ashlynblack/kbd-single/artifacts/front.png

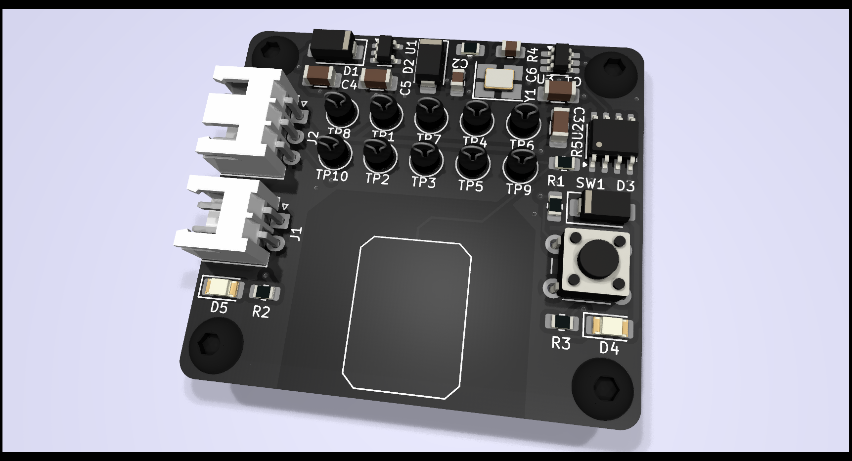
artifacts/front.png
