ashlynblack/kbd-single/artifacts/back.png

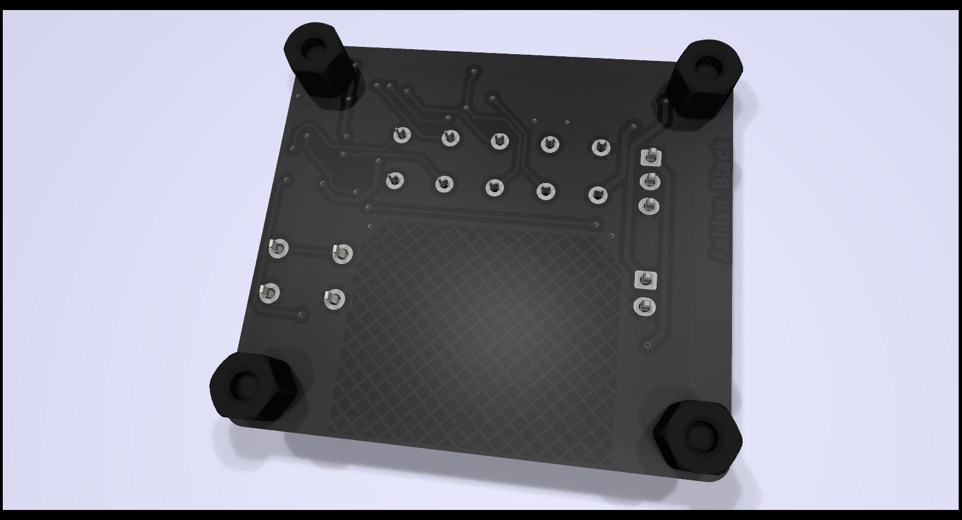
artifacts/back.png
