ashlynblack/kbd-single/artifacts/layout.pdf

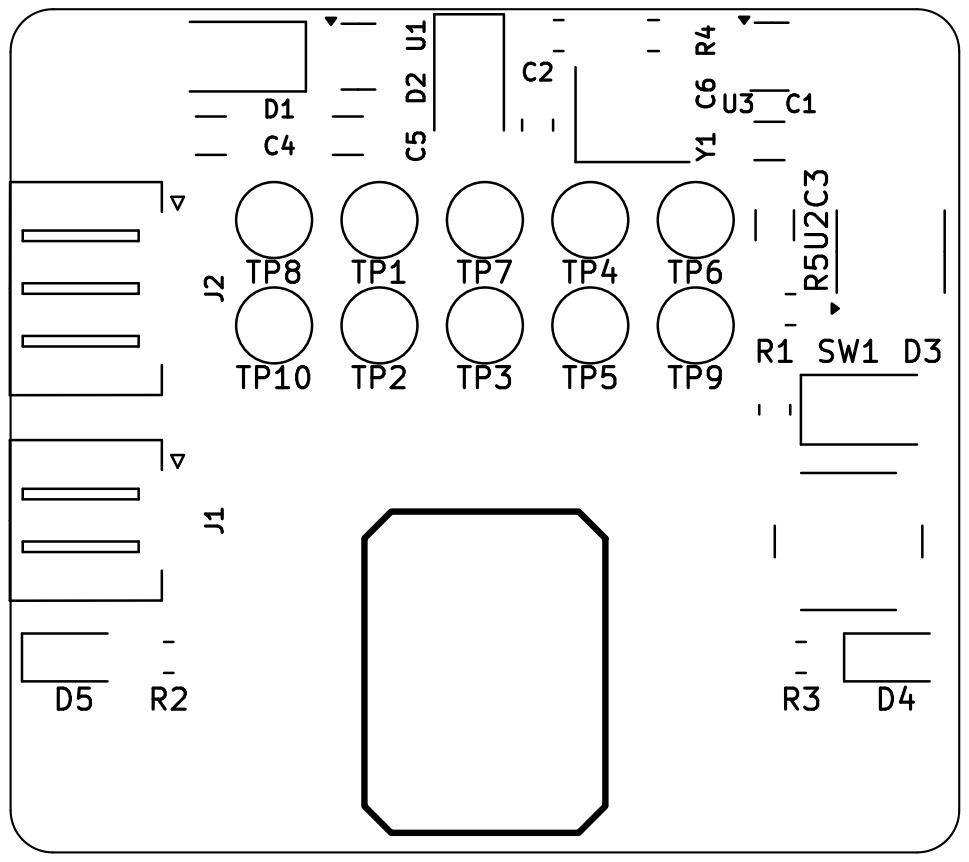
[picture p3: page 1]

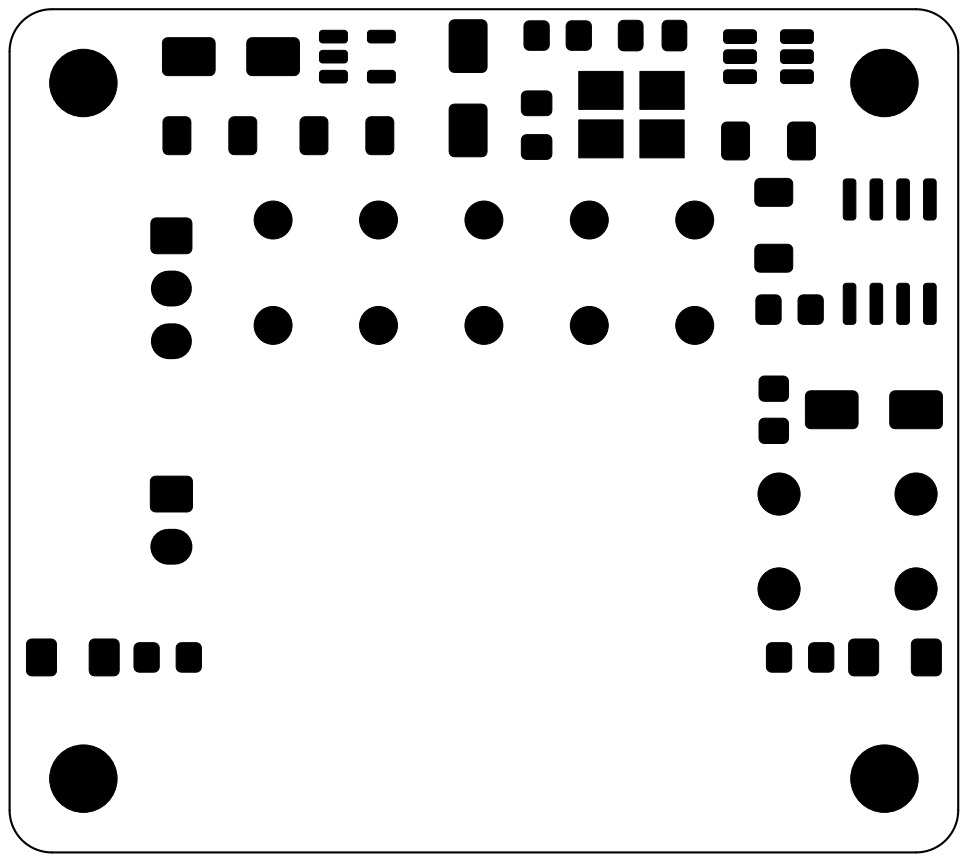
[picture p4: page 2]
D Date: 2024-07-27 KiCad; E.D.A. 8.0.4 Size: A4; Rev: 0; Id: 1/1 Title: Capacitive Touch Test File: single.kicad_pcb Sheet: Ashlyn; Black

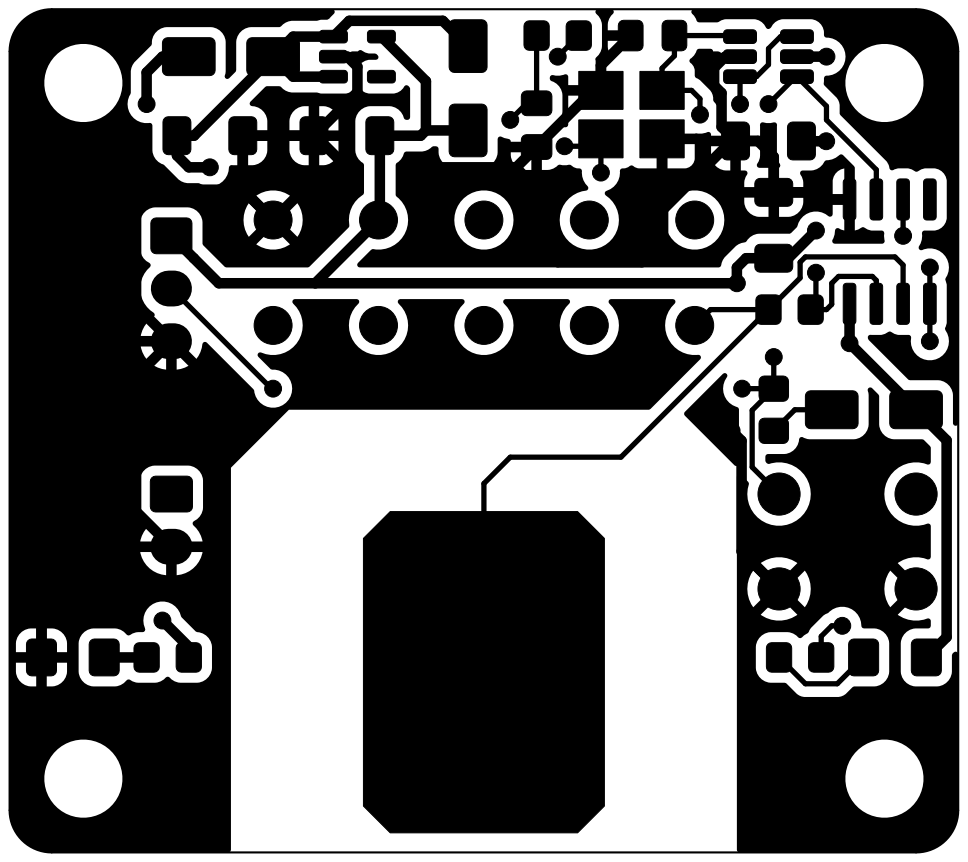
[picture p5: page 3]
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

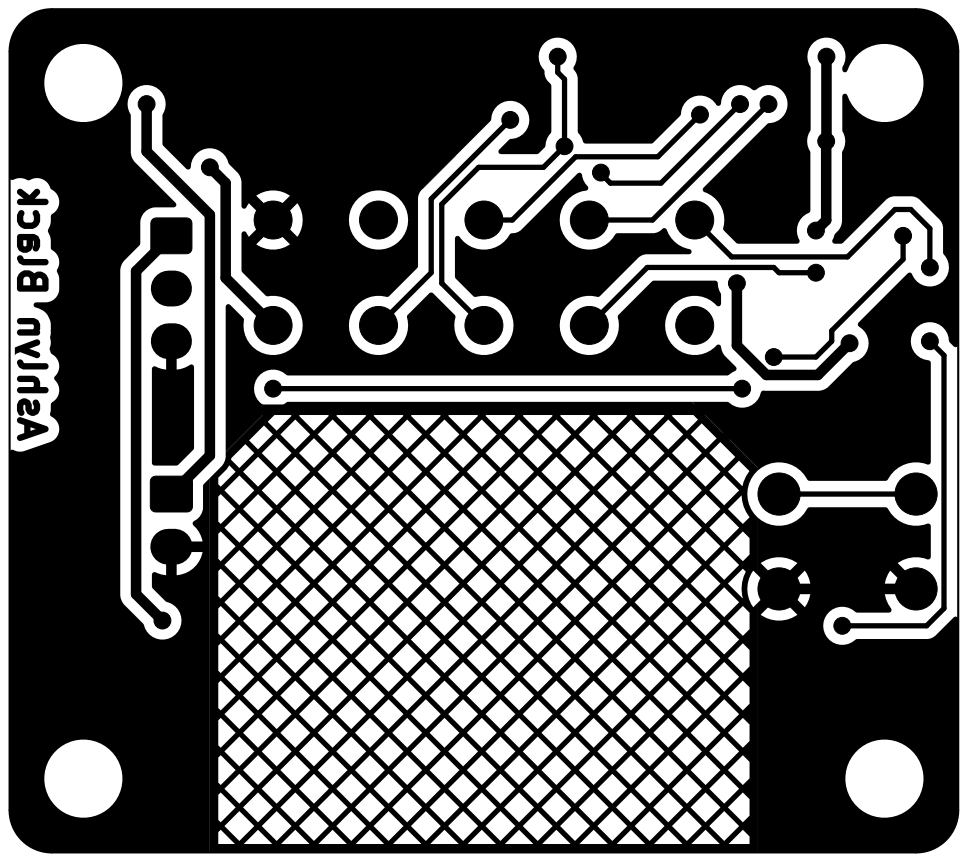
[picture p6: page 4]
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

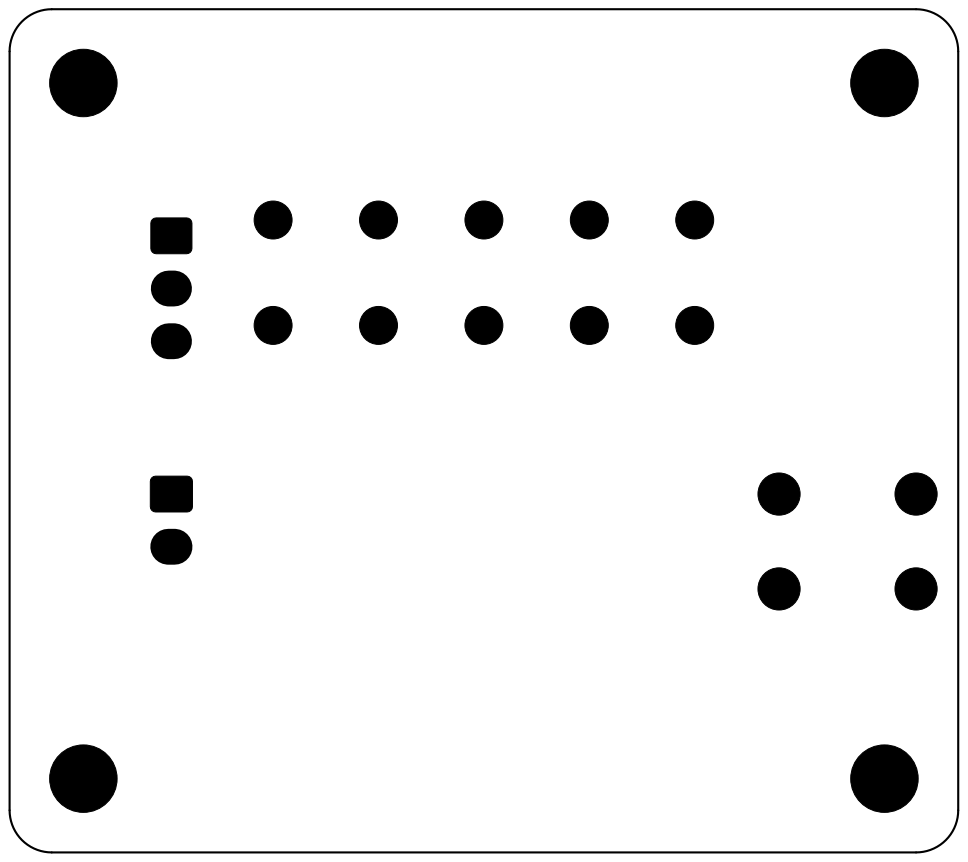
[picture p7: page 5]
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

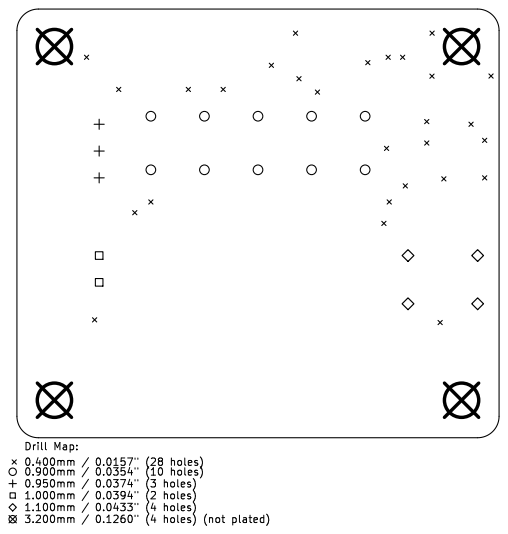
[picture p8: page 6]
Drill; Map:; holes); holes) (not; plated)
