ashlynblack/kbd-single/artifacts/schematic.pdf

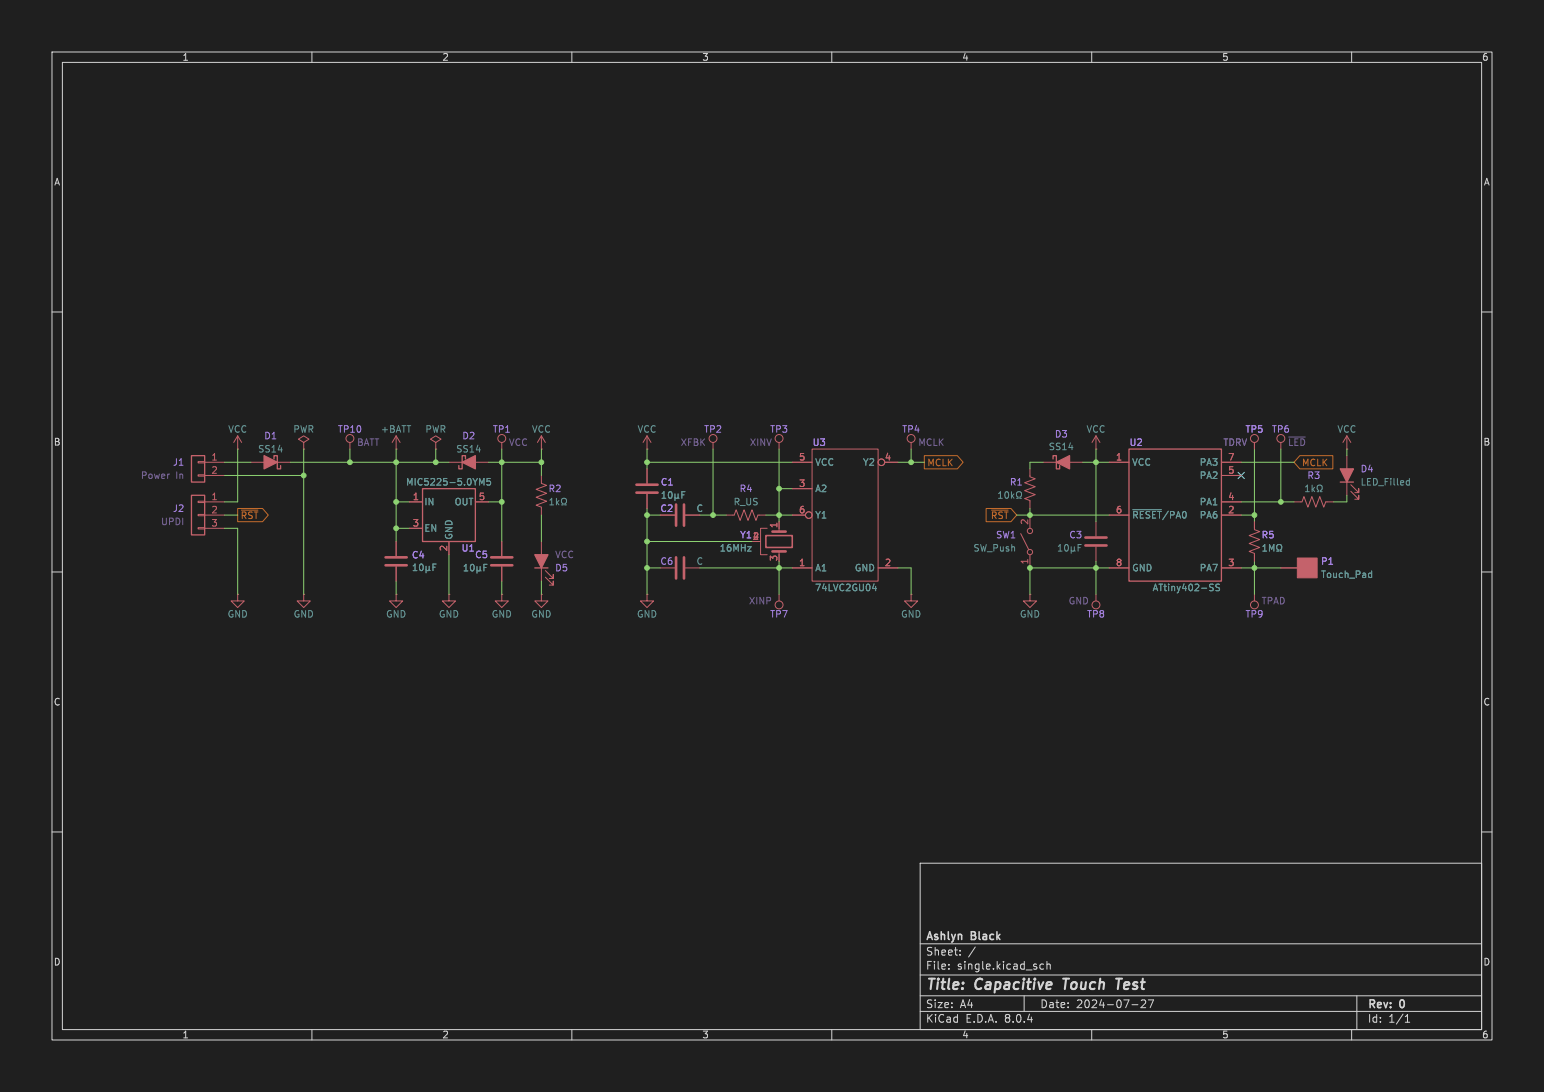
[picture p9: page 1]
