ashlynblack/kbd-single/circuitry/single.kicad_pcb

## KiCad design circuitry/single.kicad_pcb (2024-07-27)

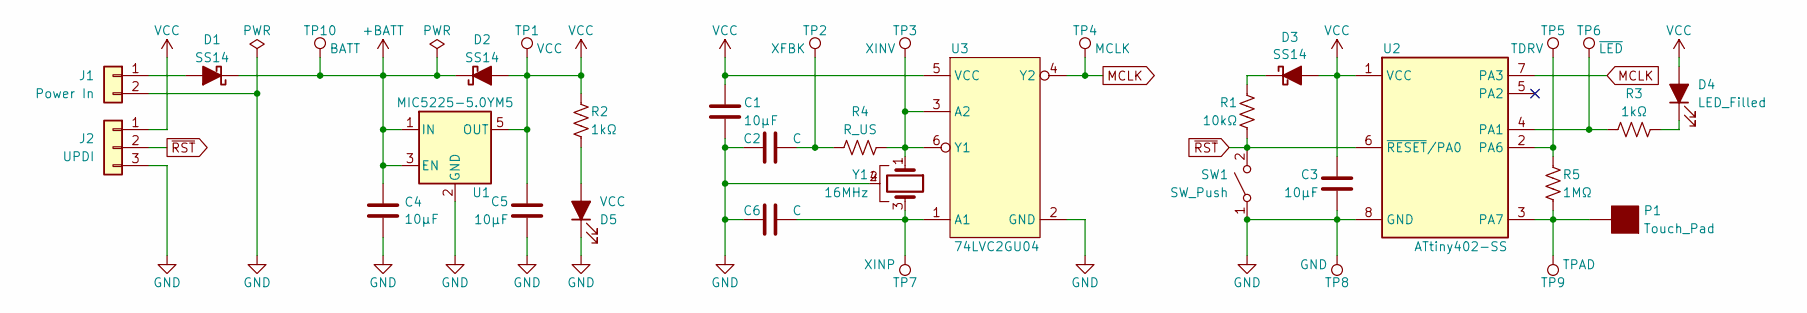
[picture p10: schematic single.kicad_sch, Capacitive Touch Test]

Parts:
C1, C3, C4, C5: 10µF; C_1206_3216Metric_Pad1.33x1.80mm_HandSolder
C2, C6: C; C_0805_2012Metric_Pad1.18x1.45mm_HandSolder
D1, D2, D3: SS14; D_SMA
D4, D5: LED_Filled; LED_1206_3216Metric_Pad1.42x1.75mm_HandSolder
J1: Conn_01x02; JST_XH_S2B-XH-A-1_1x02_P2.50mm_Horizontal
J2: Conn_01x03; JST_XH_S3B-XH-A-1_1x03_P2.50mm_Horizontal
P1: Touch_Pad
R1: 10kΩ; R_0805_2012Metric_Pad1.20x1.40mm_HandSolder
R2, R3: 1kΩ; R_0805_2012Metric_Pad1.20x1.40mm_HandSolder
R4: R_US; R_0805_2012Metric_Pad1.20x1.40mm_HandSolder
R5: 1MΩ; R_0805_2012Metric_Pad1.20x1.40mm_HandSolder; Tolerance 0.1%
SW1: SW_Push; SW_PUSH_6mm_H5mm
TP1, TP2, TP3, TP4, TP5, TP6, TP7, TP8, TP9, TP10: TestPoint; TEST-TH_Loop_D2.40mm_Drill0.9mm_Beaded
U1: MIC5225-5.0YM5; SOT-23-5
U2: ATtiny402-SS; SOIC-8_3.9x4.9mm_P1.27mm
U3: 74LVC2GU04; SOT-23-6_Handsoldering
Y1: 16MHz; Crystal_SMD_3225-4Pin_3.2x2.5mm_HandSoldering

Connections:
+BATT: C4.1, D1.1 (K), D2.1 (K), TP10.1, U1.1 (IN), U1.3 (EN)
GND: C1.2, C2.1, C3.2, C4.2, C5.2, C6.1, D5.1 (K), J1.2, J2.3, SW1.1 (A), TP8.1, U1.2 (GND), U2.8 (GND), U3.2 (GND), Y1.2, Y1.4
MCLK: TP4.1, U2.7 (PA3), U3.4 (Y2)
unnamed: C2.2, R4.1, TP2.1
unnamed: D1.2 (A), J1.1
unnamed: D3.1 (K), R1.1
unnamed: D4.1 (K), R3.2
unnamed: D5.2 (A), R2.2
unnamed: R3.1, TP6.1, U2.4 (PA1)
unnamed: R5.1, TP5.1, U2.2 (PA6)
unnamed: P1.1, R5.2, TP9.1, U2.3 (PA7)
unnamed: C6.2, TP7.1, U3.1 (A1), Y1.3
unnamed: R4.2, TP3.1, U3.3 (A2), U3.6 (Y1), Y1.1
VCC: C1.1, C3.1, C5.1, D2.2 (A), D3.2 (A), D4.2 (A), J2.1, R2.1, TP1.1, U1.5 (OUT), U2.1 (VCC), U3.5 (VCC)
~RST: J2.2, R1.2, SW1.2 (B), U2.6 (~RESET/PA0)

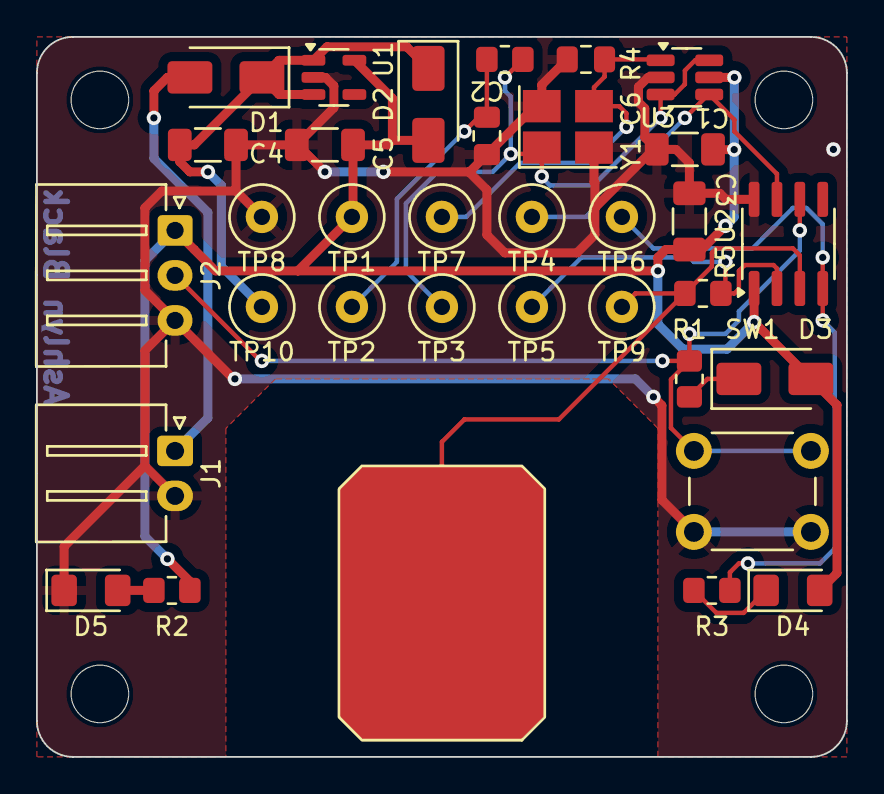
[picture p11: board single.kicad_pcb from above]

Board: 2 copper layers, 45.0 x 40.0 mm, 34 parts (0 on the bottom side), 15 nets.
