ashlynblack/kbd-single/(commit log)

2024-07-27 Completed schematic and layout.
    [single.kicad_pcb, single.kicad_sch]
2024-07-27 Generated artifacts.
    [bom.csv]
